volodyaredsun/Press-P-477A/box.jpg

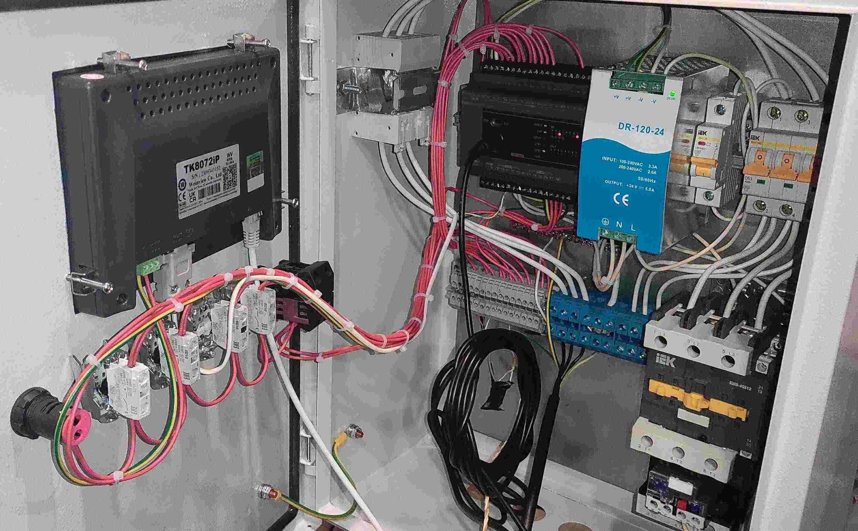
box.jpg
