volodyaredsun/Press-P-477A/p447a.jpg

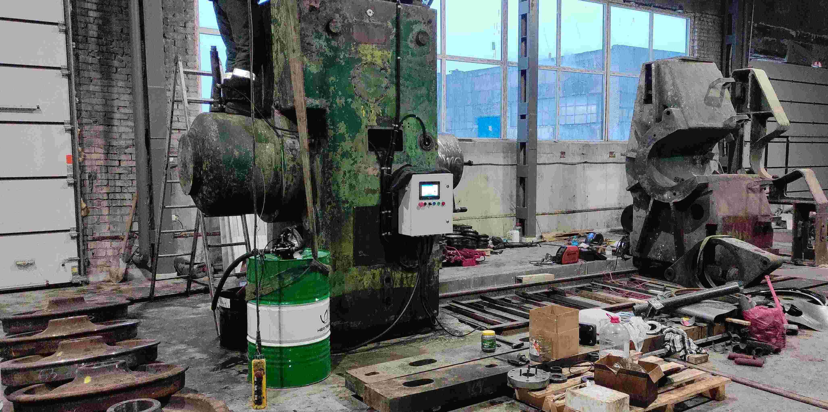
p447a.jpg
