volodyaredsun/Press-P-477A/README.md

2023.12.20
П-447А, гидравлический пресс для запрессовки и распрессовки колесных пар (колпар). Год выпуска 1951. Родной гидронасос исправный, кпд 70%, это уже маловато для данного типа насоса, но он еще поработает. Взамен пилотов управления главными золотниками,
установлены современные гидрораспределители, управляемые от 24В постоянного тока. Стояли гидравлические распределители, питаемые 220В переменным током, очень древней конструкцией.

HMI - WeinView M8072IP, среда разработки Easy Builder Pro

PLC - FX3U-20MR, среда разработки GX-Work 2
