volodyaredsun/Press-P-477A/05-SCREEN/01 - Главное окно.png

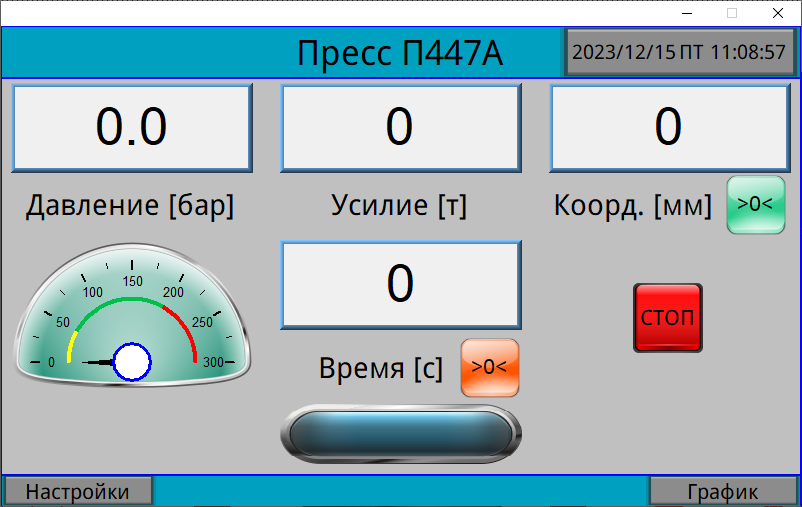
05-SCREEN/01 - Главное окно.png
