volodyaredsun/Press-P-477A/05-SCREEN/02 - Настройки.png

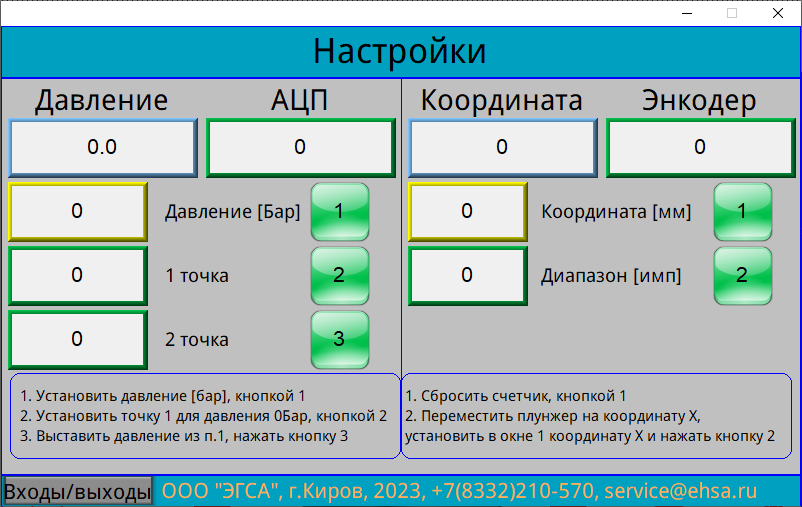
05-SCREEN/02 - Настройки.png
