volodyaredsun/Press-P-477A/05-SCREEN/03 - Входы и выходы.png

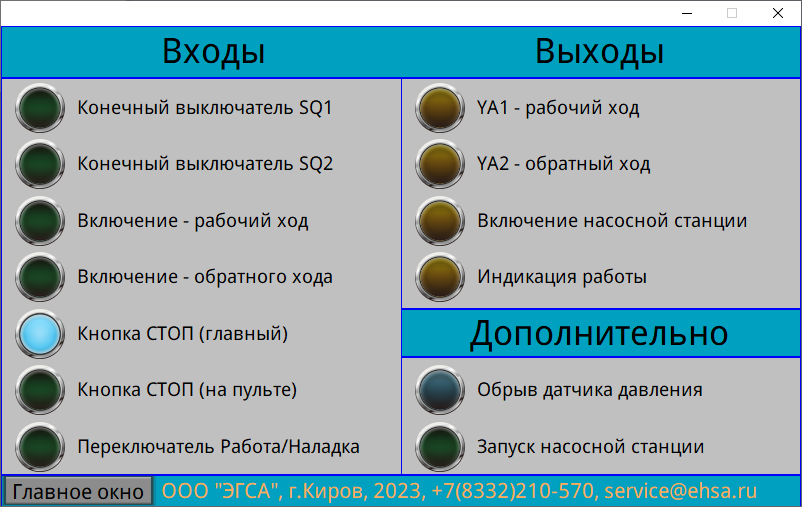
05-SCREEN/03 - Входы и выходы.png
