volodyaredsun/Press-P-477A/05-SCREEN/04 - График.png

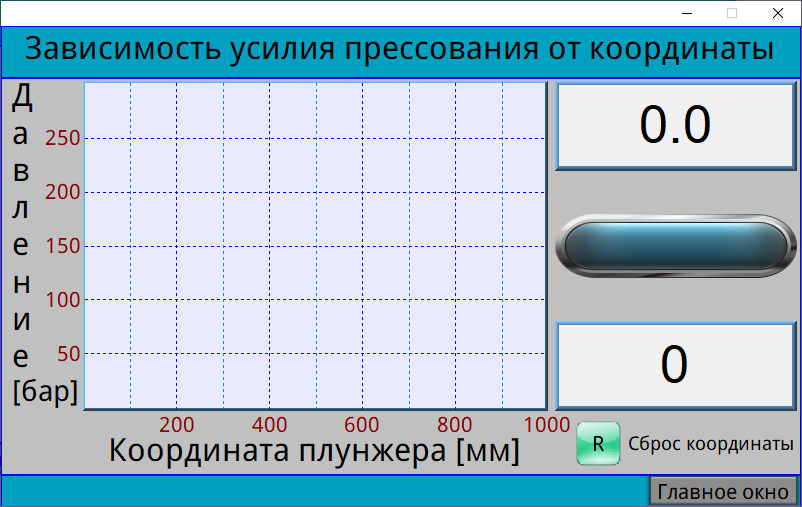
05-SCREEN/04 - График.png
