volodyaredsun/Press-P-477A/04-CODE/FX3U/adress&analog.xlsx

Sheet: Адреса ПЛК
X0 | ENC1.1 | A | Энкодер положения плунжера
X1 | ENC1.2 | B | Энкодер положения плунжера
X2 | SB1 | NC | Кнопка СТОП
X3 | SB2 | NO | Кнопка СТОП с выносного пульта
X4 | SB3 | NO | Кнопка - обратный ход
X5 | SB4 | NO | Кнопка - рабочий ход
X6 | SB5 | NO | Кнопка - запуск насосной станции
X7 | SW1 | NO | Поворотный переключатель - наладка/работа
X10 | SQ1 | NPN | Ограничение рабочего хода (КВ стоит в станке)
X11 | SQ2 | NPN | Ограничение обратного хода
X12
X13
AD0 | PE1 |  | Датчик давление плунжера 4..20мА, резистор 510Ом
AD1
AD2
AD3
Y0 | KM1 |  | Насосная станция
Y1 | YA1 |  | Рабочий ход
Y2 | YA2 |  | Обратный ход
Y3 | HL1 |  | Индикация работы
Y4
Y5
Y6
Y7

Sheet: Аналоговый вход
Xin0 | начальное значнеие 4мА, от чего меряем |  | M = dS / (XinM - Xin0)
XinM | Максимальное значение АЦП при поданном размахе сигнала
dS | размах сигнала от 0 до Х Бар (для вычисления масштаба)
 |  | 510
Давление [Бар] | Ток датчика [mA] | Напряжение [В]
0 | 4 | #REF!
200 | 10.66666667 | #REF!
300 | 20 | #REF!
 | dI = 16mA
 | mI = dI / dP = 16 / 300

Sheet: Переменные глобальные
VAR_GLOBAL | ENC_A | Bit |  | X000 |  | Энкодер А
VAR_GLOBAL | ENC_B | Bit |  | X001 |  | Энкодер В
VAR_GLOBAL | STOP_main_SB1 | Bit |  | X002 |  | Главный СТОП
VAR_GLOBAL | STOP_rem_SB2 | Bit |  | X003 |  | Стоп с выносоного пульта
VAR_GLOBAL | RM_SB5 | Bit |  | X004 |  | Обратный ход
VAR_GLOBAL | WM_SB4 | Bit |  | X005 |  | Рабочий ход
VAR_GLOBAL | RUN_SB3 | Bit |  | X006 |  | Запуск насосной станции
VAR_GLOBAL | Work_set_SW1 | Bit |  | X007 |  | Работа/Наладка
VAR_GLOBAL | WM_SQ1 | Bit |  | X010 |  | Ограничение рабочего хода (внутри станка)
VAR_GLOBAL | RM_SQ2 | Bit |  | X011 |  | Ограничение обратного хода
VAR_GLOBAL | Pump_KM1 | Bit |  | Y000 |  | Запуск насосной станции (КМ1)
VAR_GLOBAL | WM_YA1 | Bit |  | Y004 |  | Рабочий ход (YA1)
VAR_GLOBAL | RM_YA2 | Bit |  | Y005 |  | Обратный ход (YA2)
VAR_GLOBAL | Lamp | Bit |  | Y006 |  | Индикация работы
VAR_GLOBAL | STOP_rem_bit | Bit |  | M0 |  | СТОП с выносного пульта
VAR_GLOBAL | RUN_pump_bit | Bit |  | M1 |  | Запуск насосной станции
VAR_GLOBAL | WM_time_rset | Bit |  | M2 |  | Бит, сброса времени рабочего хода
VAR_GLOBAL | WM_bit_s | Bit |  | M3 |  | Работа - рабочий ход
VAR_GLOBAL | RM_bit_s | Bit |  | M4 |  | Работа - обратный ход
VAR_GLOBAL | WM_bit_p | Bit |  | M5 |  | Наладка - рабочий ход
VAR_GLOBAL | RM_bit_p | Bit |  | M6 |  | Наладка - обратный ход
VAR_GLOBAL | ENC_reset | Bit |  | M7 |  | Сброс счетчика энкодера
VAR_GLOBAL | P0_adc_set | Bit |  | M30 |  | Установка точки 0 АЦП
VAR_GLOBAL | P1_adc_set | Bit |  | M31 |  | Установка точки 1 АЦП
VAR_GLOBAL | ds_set | Bit |  | M32 |  | Установка диапазона давления
VAR_GLOBAL | P_break | Bit |  | M33 |  | Обрыв датчика давления
VAR_GLOBAL | ENC_dS_set | Bit |  | M40 |  | Вычисление масштаба энкодера
VAR_GLOBAL | Plot_run | Bit |  | M41 |  | График рисуем
VAR_GLOBAL | Plot_stop | Bit |  | M42 |  | График не рисуем
VAR_GLOBAL | Upper_in | Word[Signed] |  | D0 |  | Настройка верхнего диапазона АЦП
VAR_GLOBAL | Lower_in | Word[Signed] |  | D1 |  | Настройка нижнего диапазона АЦП
VAR_GLOBAL | Filter_in | Word[Signed] |  | D2 |  | Настройка фильтра АЦП
VAR_GLOBAL | ADC0 | Word[Signed] |  | D10 |  | Значение с АЦП 0 канал
VAR_GLOBAL | PlotXY_control | Word[Signed] |  | D20
VAR_GLOBAL | dS_buf | Word[Signed] |  | D30 |  | Буффер для диапазона давления
VAR_GLOBAL | Xin0_buf | Word[Signed] |  | D31 |  | Буффер для точки 0 АЦП
VAR_GLOBAL | XinM_buf | Word[Signed] |  | D32 |  | Буффур для точки 1 АЦП
VAR_GLOBAL | deltaX | Word[Signed] |  | D33 |  | Разница 0 и 1 точки АЦП для настроки
VAR_GLOBAL | dS_f | FLOAT (Single Precision) |  | D36 | 2 word | Значение давления с датчика
VAR_GLOBAL | deltaX_f | FLOAT (Single Precision) |  | D38 | 2 word | Float для диапазона давления
VAR_GLOBAL | ADC0_f | FLOAT (Single Precision) |  | D40 | 2 word | Float для разницы точек 0 и 1 АЦП
VAR_GLOBAL | Mx_buf_f | FLOAT (Single Precision) |  | D42 | 2 word | Float для значения с АЦП (минус уже начальное значение Xin0)
VAR_GLOBAL | ADC_Xin0 | Double Word[Signed] |  | D44 | 2 word | Разница 0 и 1 точки АЦП для отображения
VAR_GLOBAL | Pressure_f | FLOAT (Single Precision) |  | D48 | 2 word | Давление [Бар]
VAR_GLOBAL | Length_f | FLOAT (Single Precision) |  | D50 | 2 word | Координата плунжера
VAR_GLOBAL | ENC_cnt | Double Word[Signed] |  | D52 | 2 word | Счетчик энкодера
VAR_GLOBAL | ENC_cnt_f | FLOAT (Single Precision) |  | D54 | 2 word | Float счетчика энкодера
VAR_GLOBAL | ENC_dS_buf | Double Word[Signed] |  | D56 | 2 word | Буфер для диапазона перемещений плунжера
VAR_GLOBAL | ENC_imp_buf | Double Word[Signed] |  | D58 | 2 word | Буфер для импульсов на диапазон перемещений плунжера
VAR_GLOBAL | ENC_imp_f | FLOAT (Single Precision) |  | D60 | 2 word | Float импульсов на диапазон перемещений плунжера
VAR_GLOBAL | ENC_dS_f | FLOAT (Single Precision) |  | D62 | 2 word | Float диапазона перемещений плунжера
VAR_GLOBAL | ENC_C251 | Double Word[Signed] |  | D64 | 2 word | Зачем то нужен регистр для счетчика
VAR_GLOBAL | Xin0_eep | Word[Signed] |  | D200 |  | Точка 0 АЦП в энергонезависимой памяти
VAR_GLOBAL | XinM_eep | Word[Signed] |  | D201 |  | Точка 1 АЦП в энергонезависимой памяти
VAR_GLOBAL | dS_eep | Word[Signed] |  | D202 |  | Диапазон давления в энергонезависимой памяти
VAR_GLOBAL | Mx_f_eep | FLOAT (Single Precision) |  | D203 | 2 word | Масштаб давления в энергонезависимой памяти
VAR_GLOBAL | ENC_M_f_eep | FLOAT (Single Precision) |  | D205 | 2 word | Масштаб энкодера в энергонезависимой памяти
VAR_GLOBAL | ENC_imp_eep | Double Word[Signed] |  | D207 | 2 word | Значение счетчика на диапазон перемещения в энергонезависимой памяти
VAR_GLOBAL | ENC_dS_eep | Double Word[Signed] |  | D209 | 2 word | Диапазон перемещения в энергонезависимой памяти
VAR_GLOBAL_CONSTANT | Break_press_const | Word[Signed] | K700 |  |  | Константа, нулевое значение с датчика давления (4мА)
VAR_GLOBAL_CONSTANT | Lamp_time_const | Word[Signed] | K20 |  |  | Полупериод моргания лампы
VAR_GLOBAL_CONSTANT | Time_WM_const | Word[Signed] | K300 |  |  | Максимальное время рабочего хода
VAR_GLOBAL | WM_cnt | Counter |  | C1 |  | Счетчик для кнопки - рабочий ход
VAR_GLOBAL | RM_cnt | Counter |  | C2 |  | Счетчик для кнопки - обратный ход
VAR_GLOBAL | WM_time | Counter |  | C3 |  | Счетчик - время рабочего хода
VAR_GLOBAL | Lamp_on | Timer |  | T1 |  | Таймер 1 полупериода моргания лампы
VAR_GLOBAL | Lamp_off | Timer |  | T2 |  | Таймер 2 полупериода моргания лампы
