volodyaredsun/Press-P-477A/01-DOCs/05 - Входа FX3U (срисовано).pdf

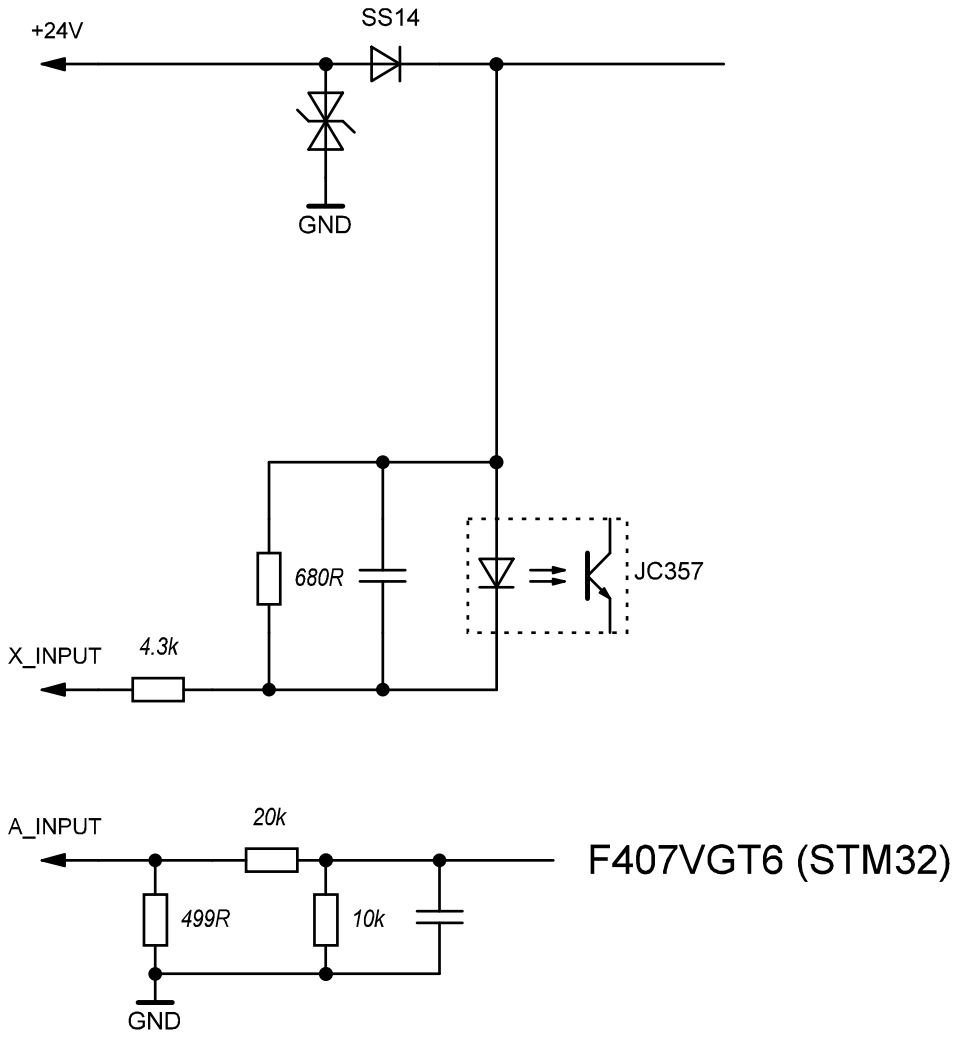
[picture p7: page 1]
