volodyaredsun/Press-P-477A/(list of files, drawings)

Other design files:
02-SCHEMES/P447A.spl8
