volodyaredsun/Press-P-477A/(commit log)

2024-03-17 Add files via upload
    Create beginner commit
    [P447A[1].spl8]
2024-03-18 Rename P447A[1].spl8 to P447A.spl8
    rename
    [P447A.spl8]
